Evanston09/pentos/hardware/manual/assets/blender/08-b-homing.png

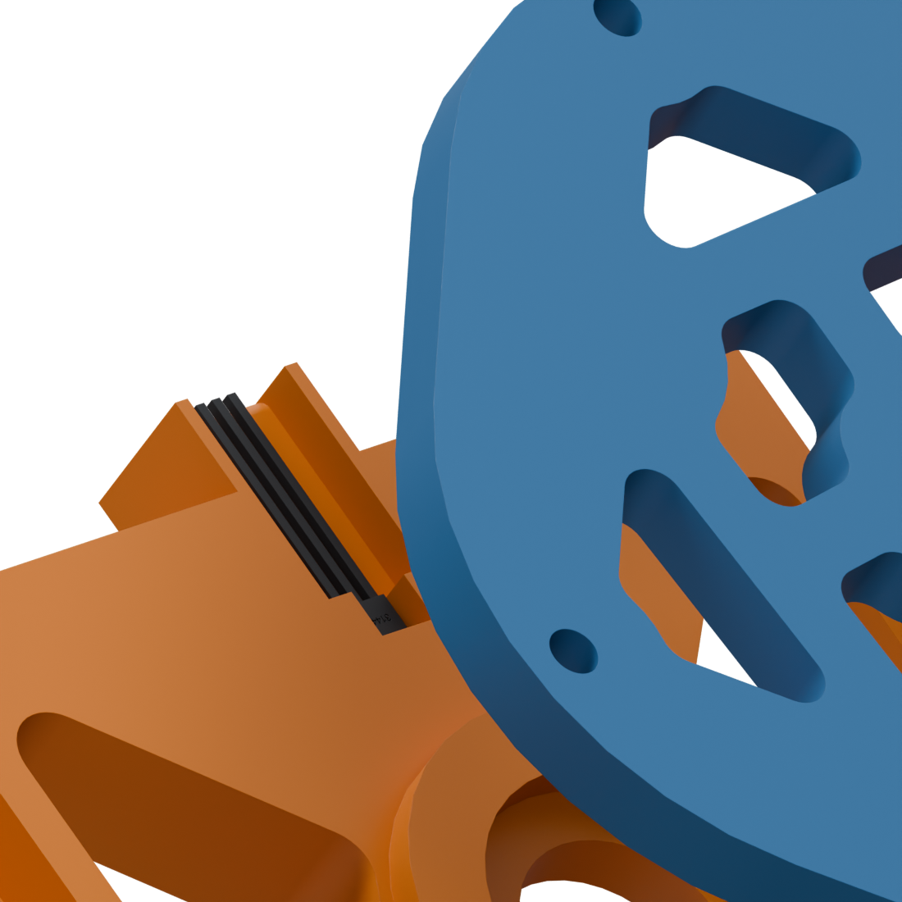
hardware/manual/assets/blender/08-b-homing.png
