Evanston09/pentos/hardware/manual/assets/blender/06-b-drive.png

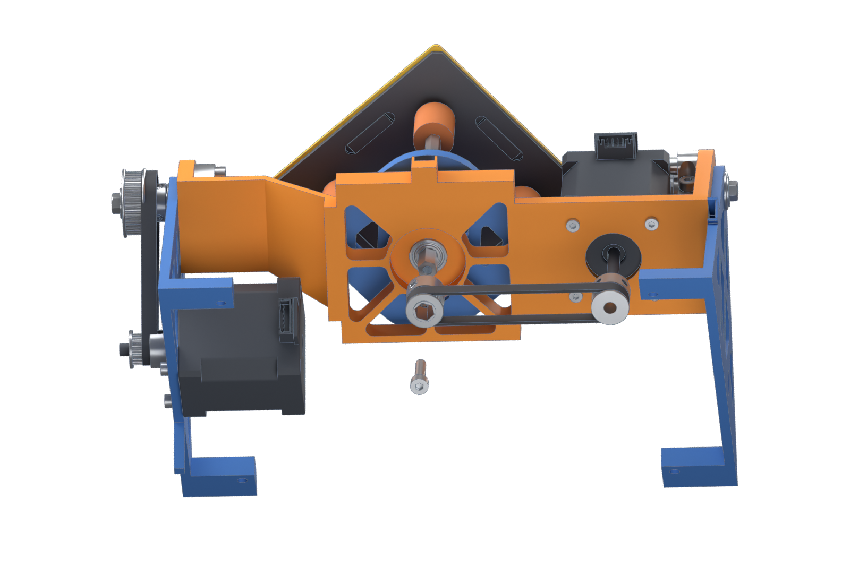
hardware/manual/assets/blender/06-b-drive.png
