Evanston09/pentos/hardware/manual/assets/blender/04b-cradle-hardware.png

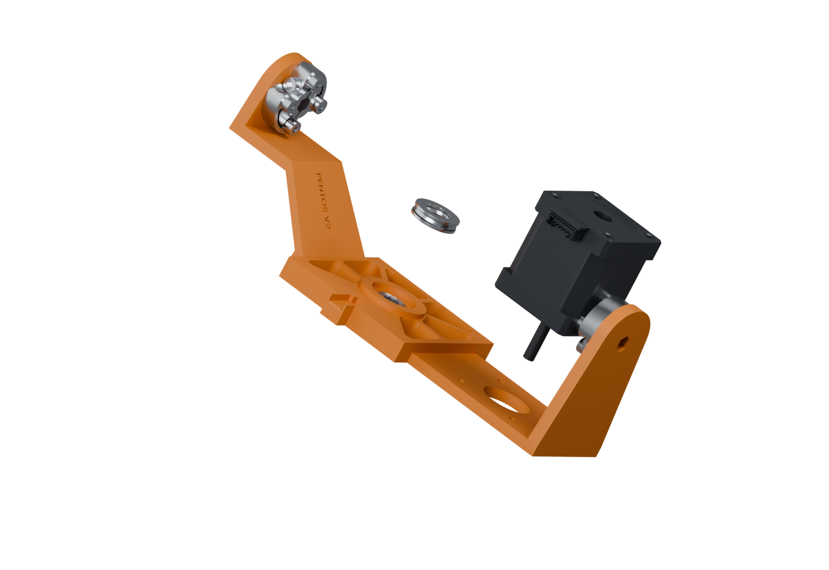
hardware/manual/assets/blender/04b-cradle-hardware.png
