Evanston09/pentos/hardware/manual/assets/blender/overview.png

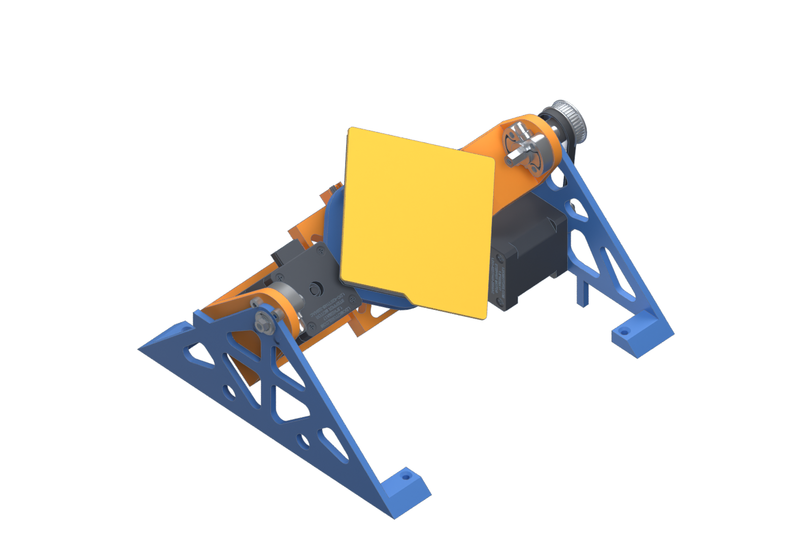
hardware/manual/assets/blender/overview.png
