Evanston09/pentos/hardware/manual/assets/pentos-paper-render.png

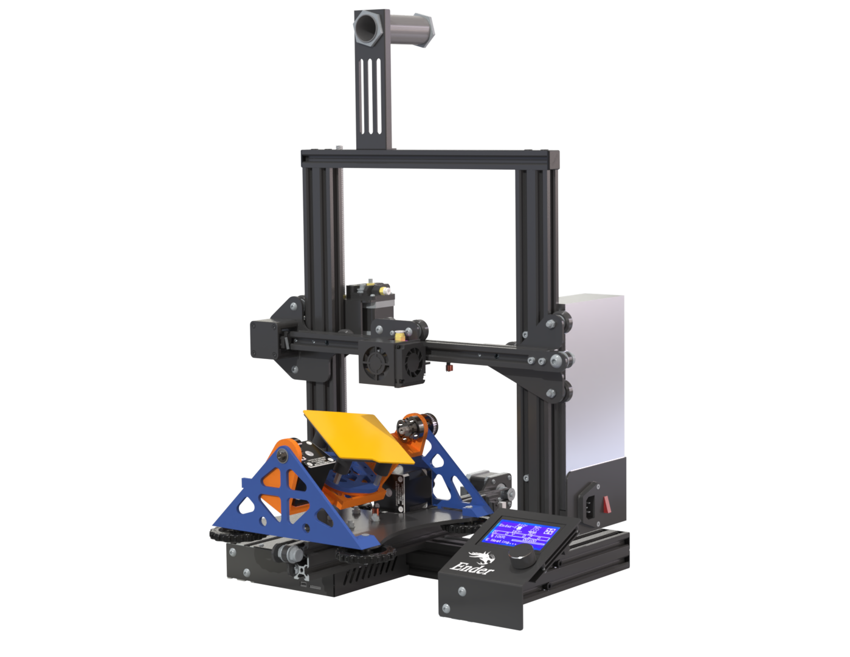
hardware/manual/assets/pentos-paper-render.png
