Evanston09/pentos/hardware/cad/a-axis-cradle.step

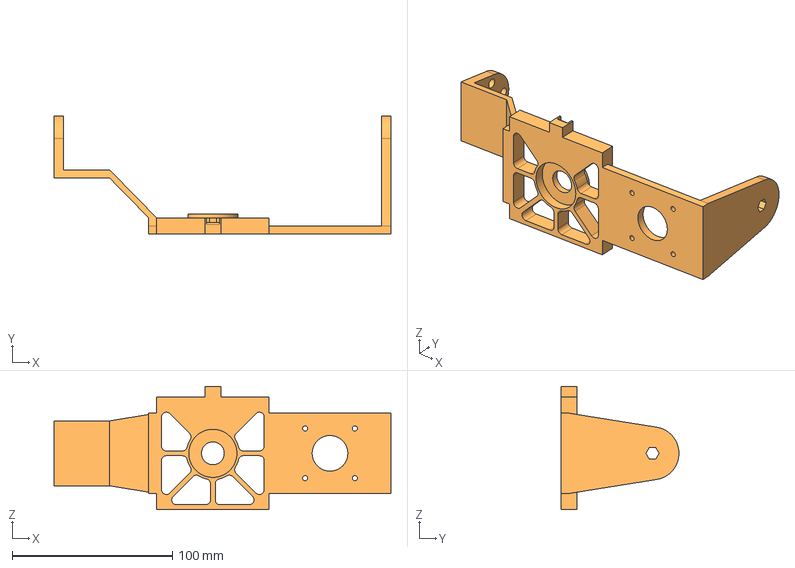
[picture p6: CAD file, 2026-11-12]
hardware/cad/a-axis-cradle.step
210.0 x 73.5 x 76.7 mm
