Evanston09/pentos/hardware/manual/Creality-Ender3-V2 - Bed Level Knob.step

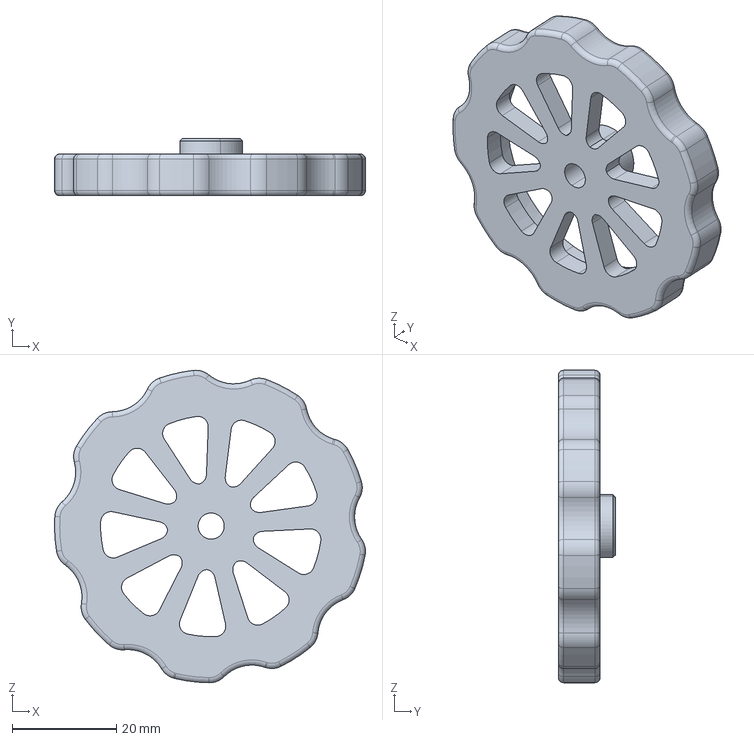
[picture p7: CAD file, 2026-11-12]
hardware/manual/Creality-Ender3-V2 - Bed Level Knob.step
59.5 x 11.0 x 59.8 mm
