Evanston09/pentos/hardware/manual/slicing/a-axis-cradle-magnet-pause.3mf

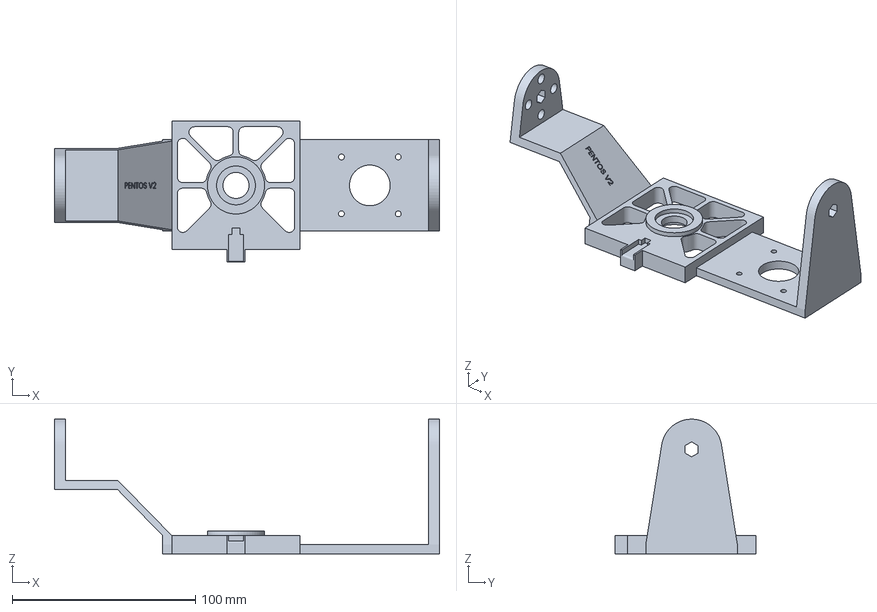
[picture p8: CAD file, 2026-11-12]
hardware/manual/slicing/a-axis-cradle-magnet-pause.3mf
210.0 x 76.7 x 73.5 mm
