Evanston09/pentos/hardware/Pentos.step

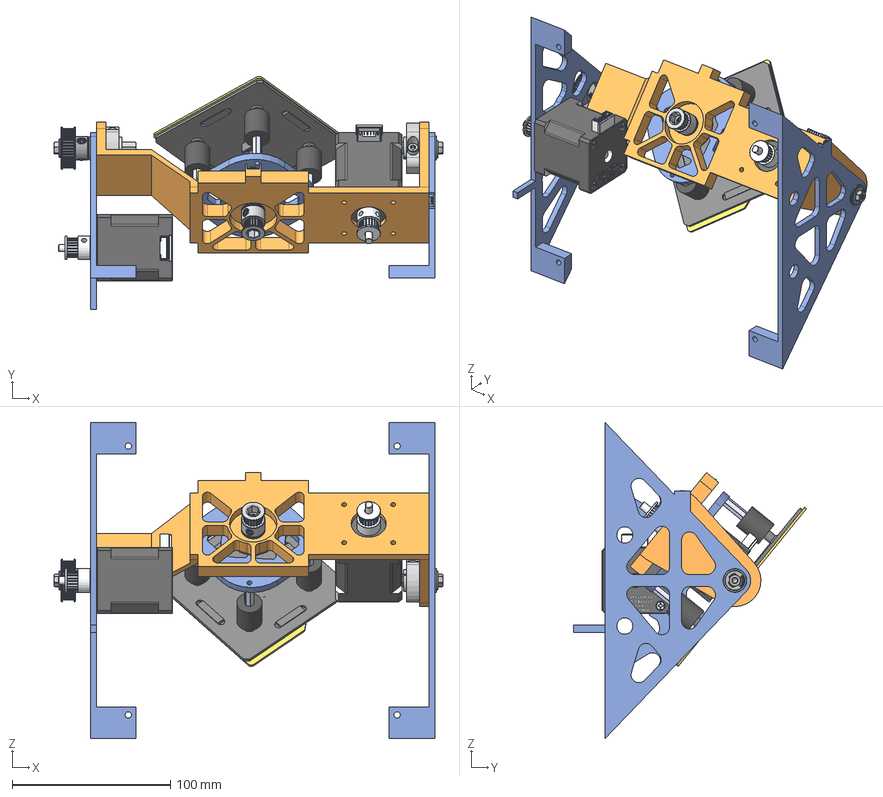
[picture p9: CAD file, 2026-11-12]
hardware/Pentos.step
246.0 x 147.5 x 200.0 mm
Gates_2GT_20T_Toothed_Pulley x 2
2106 Series 8mm REX e-clip
2106 Series Stainless Steel REX Shaft (8mm Diameter, 52mm Length)
outer race x 3
inner race x 3
1309 Series Sonic Hub (8mm REX® Bore) 1309-0016-4 008 x 2
8mm REX® Shaft with E-Clip (Stainless Steel, 32mm Length) 2106-40 08-0320 x 2
2806-0005-0004 v8
Sensor x 2
U-Axis Holder Back
2mm Pitch GT2 Pinion Timing Pulley (8mm REX Bore, 20 Tooth) 3422-400 8-0020
LDO Nema_17_47STH (höhe 48 mm) v4 x 2
U-Axis Craddle
U-Axis Holder
Washer x 2
Carriage With Balls
REV-41-1489 x 4
Buildplate
Spacer x 4
Magnet x 2
V-Axis Base
Prusa Magnetic Heatbed Tile v3
