Evanston09/pentos/hardware/printable-parts/b-axis-base.3mf

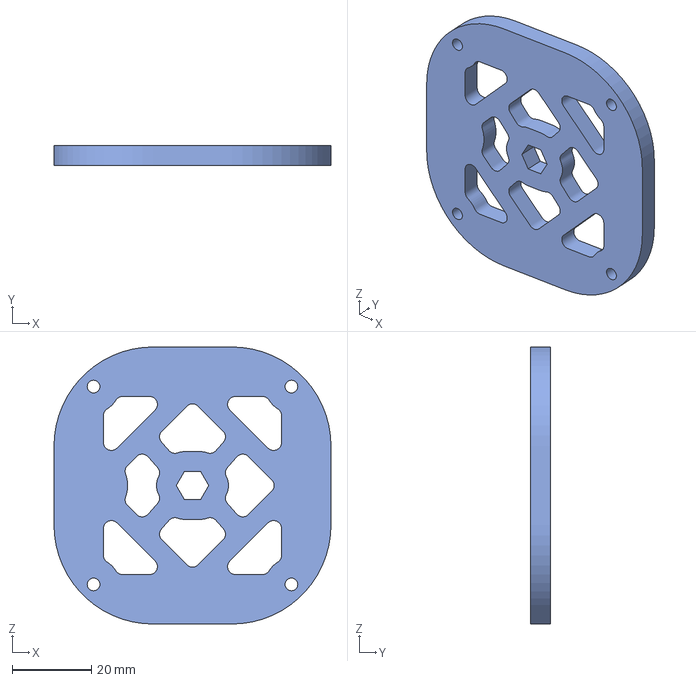
[picture p10: CAD file, 2026-11-12]
hardware/printable-parts/b-axis-base.3mf
70.0 x 5.00 x 70.0 mm
