Evanston09/pentos/hardware/cad/rex-shaft-e-clip.step

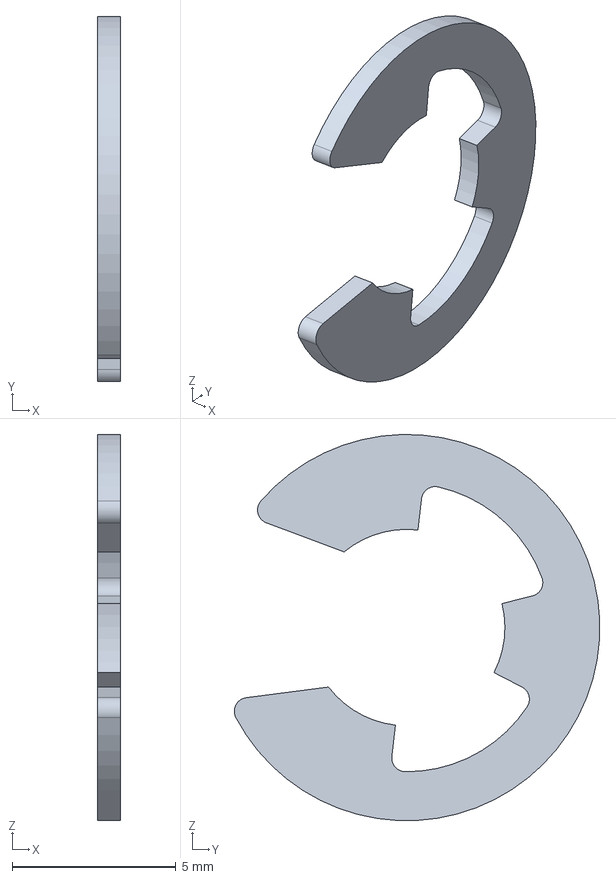
[picture p11: CAD file, 2026-11-12]
hardware/cad/rex-shaft-e-clip.step
0.7 x 11.2 x 11.8 mm
