Evanston09/pentos/hardware/manual/Creality-Ender3-V2 - Y-Gantry.step

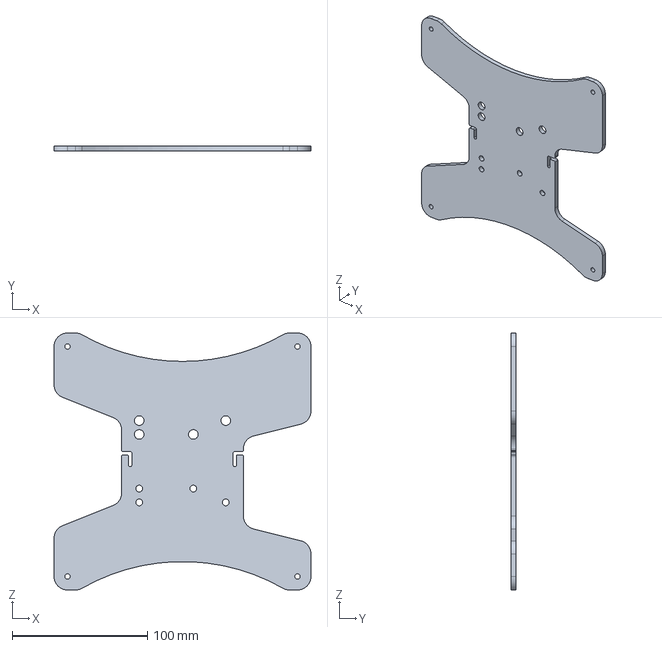
[picture p12: CAD file, 2026-11-12]
hardware/manual/Creality-Ender3-V2 - Y-Gantry.step
190.0 x 4.00 x 190.0 mm
