Evanston09/pentos/hardware/cad/a-axis-holder-back.step

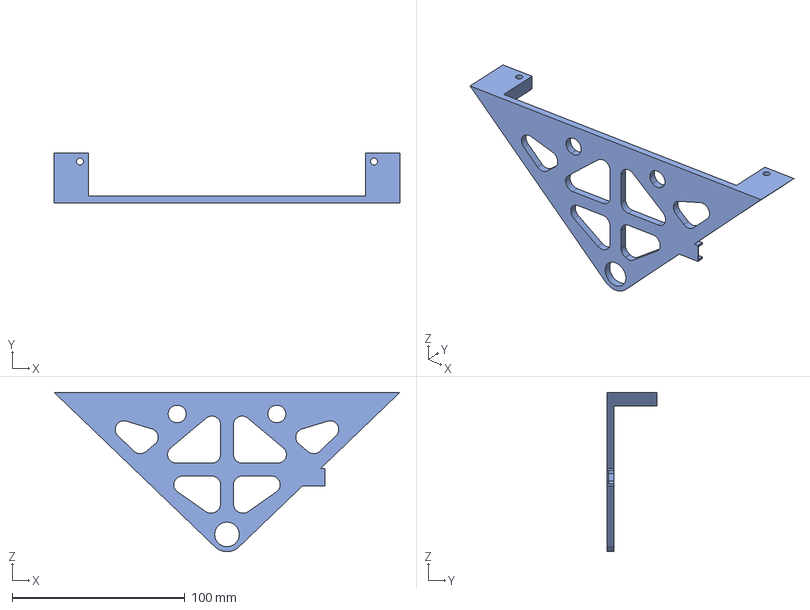
[picture p13: CAD file, 2026-11-12]
hardware/cad/a-axis-holder-back.step
200.0 x 29.0 x 92.1 mm
