Evanston09/pentos/hardware/cad/a-axis-holder-front.step

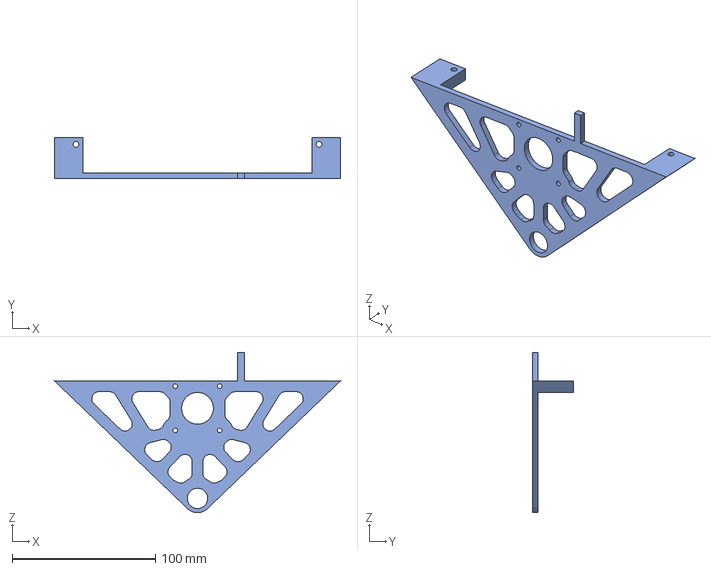
[picture p14: CAD file, 2026-11-12]
hardware/cad/a-axis-holder-front.step
200.0 x 29.0 x 112.1 mm
