Evanston09/pentos/(list of files, cad)

Other CAD files:
hardware/manual/slicing/b-axis-base-magnet-pause.3mf
hardware/manual/pentos-assembly.blend
hardware/manual/pentos-mounted.blend
hardware/printable-parts/a-axis-cradle.3mf
hardware/printable-parts/a-axis-holder-back.3mf
hardware/printable-parts/a-axis-holder-front.3mf
