Evanston09/pentos/hardware/manual/assets/a-drive-photo.jpg

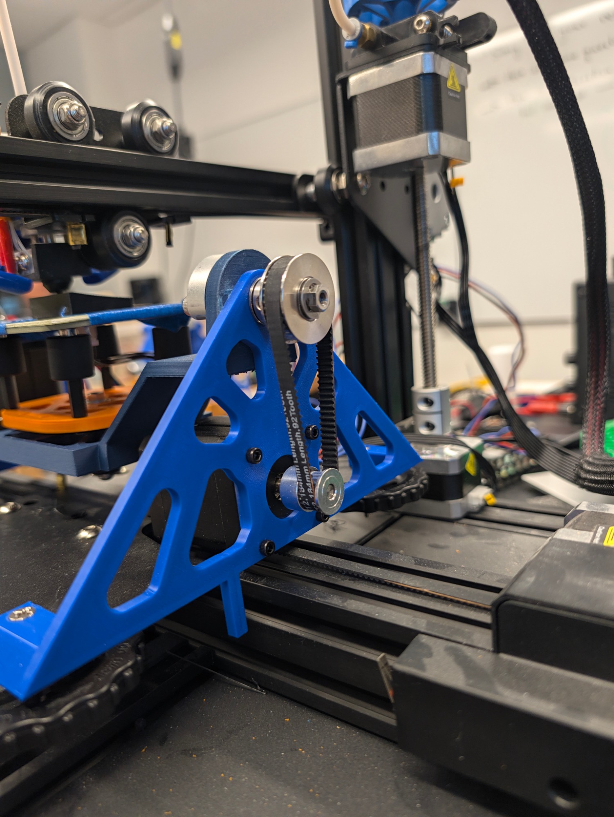
hardware/manual/assets/a-drive-photo.jpg
