Evanston09/pentos/hardware/manual/assets/a-homing-reference.png

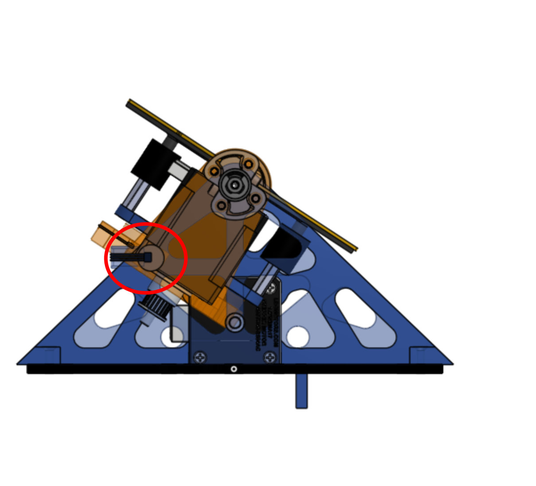
hardware/manual/assets/a-homing-reference.png
