Evanston09/pentos/hardware/manual/assets/assembly.png

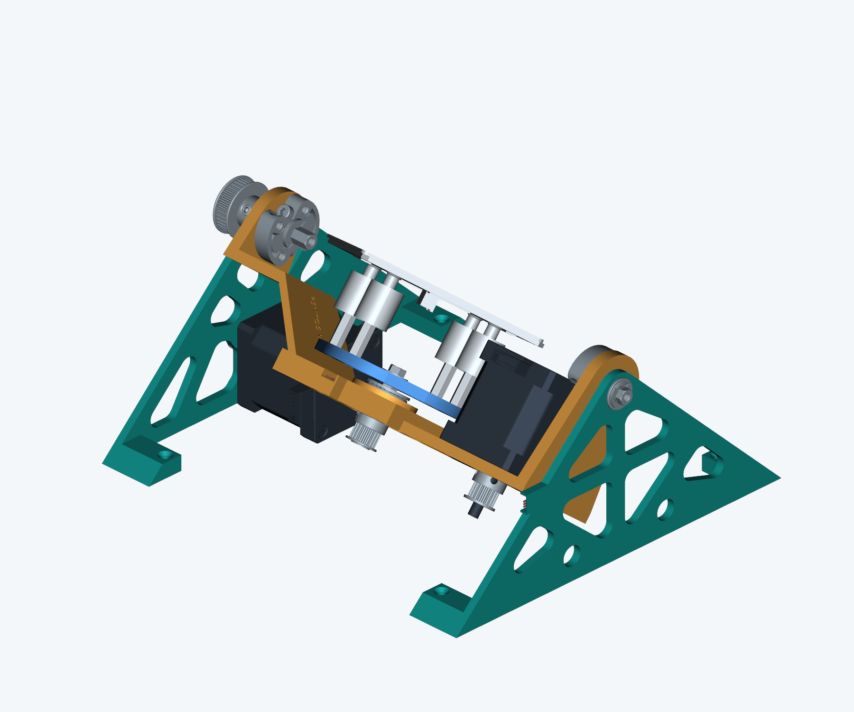
hardware/manual/assets/assembly.png
