Evanston09/pentos/hardware/manual/assets/b-drive-photo.jpg

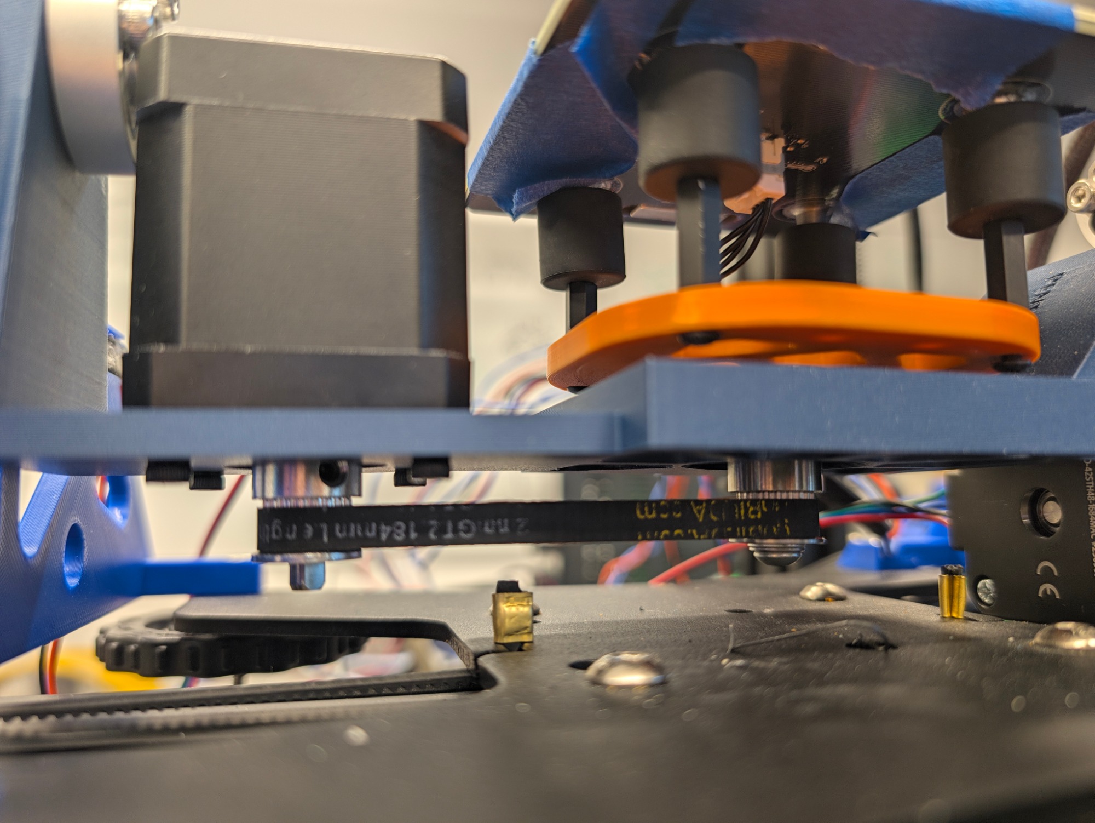
hardware/manual/assets/b-drive-photo.jpg
