Evanston09/pentos/hardware/manual/assets/b-homing-reference.png

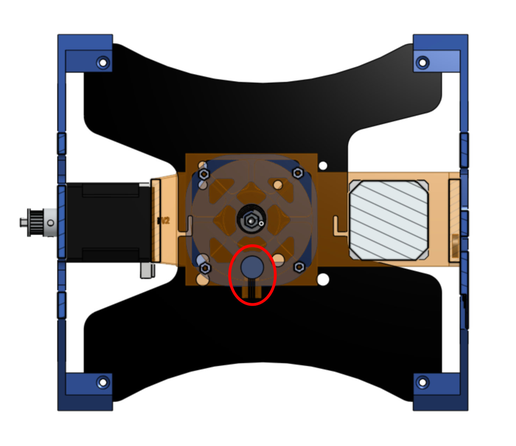
hardware/manual/assets/b-homing-reference.png
