Evanston09/pentos/hardware/manual/assets/bed.png

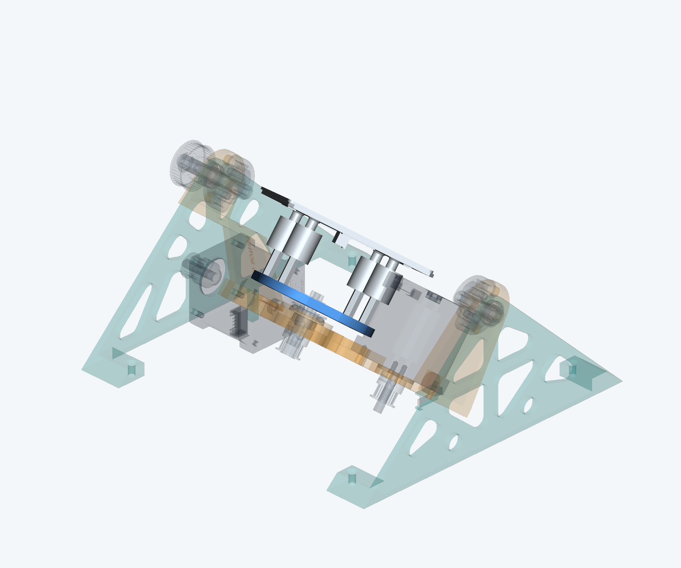
hardware/manual/assets/bed.png
