Evanston09/pentos/hardware/manual/assets/blender/01-bed.png

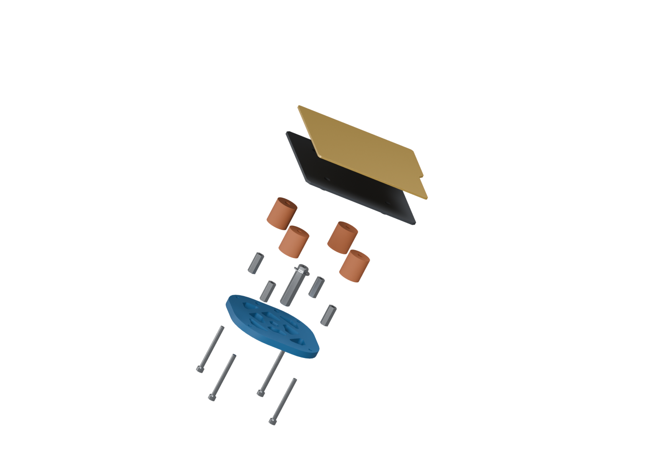
hardware/manual/assets/blender/01-bed.png
