Evanston09/pentos/hardware/manual/assets/blender/02-hubs.png

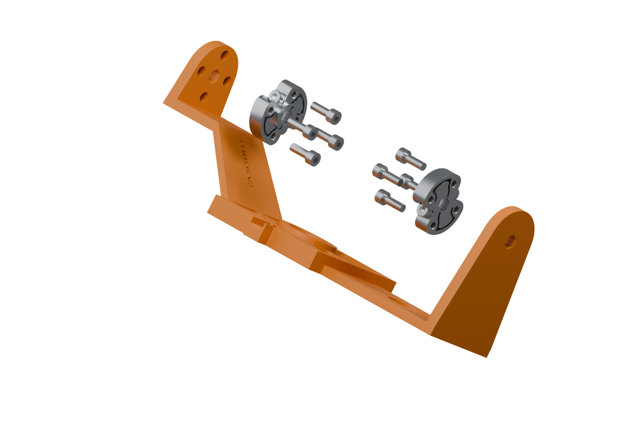
hardware/manual/assets/blender/02-hubs.png
