Evanston09/pentos/hardware/manual/assets/blender/03-holders.png

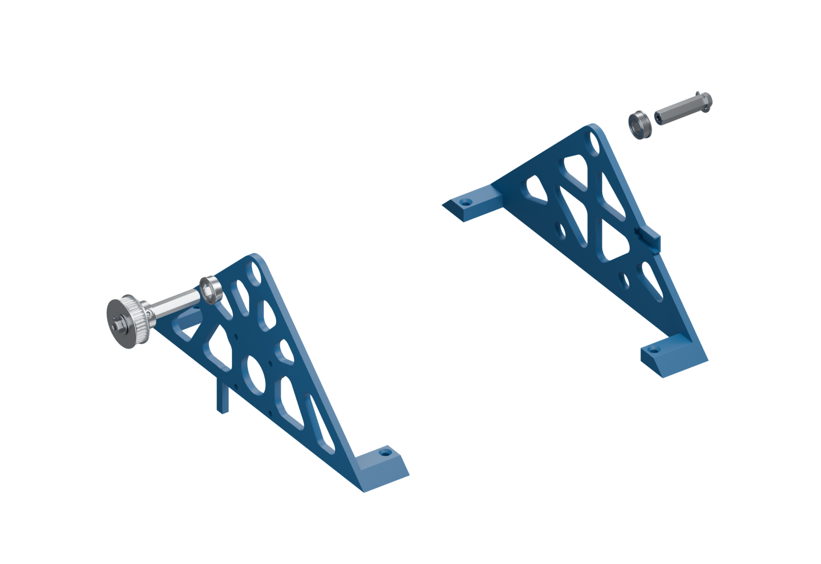
hardware/manual/assets/blender/03-holders.png
