Evanston09/pentos/hardware/manual/assets/blender/04-a-drive.png

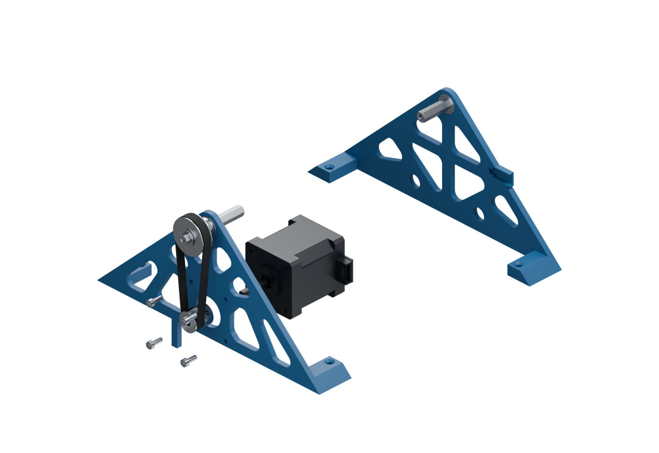
hardware/manual/assets/blender/04-a-drive.png
