Evanston09/pentos/hardware/manual/assets/blender/04a-cradle-bearing.png

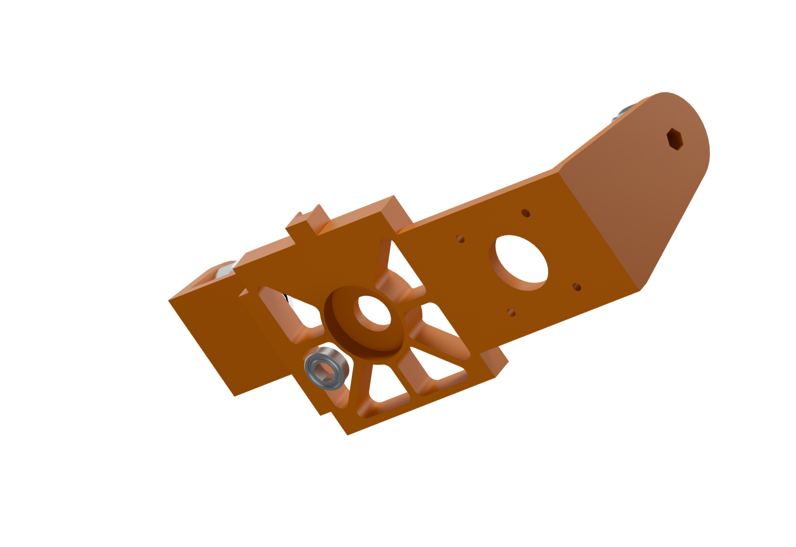
hardware/manual/assets/blender/04a-cradle-bearing.png
