Evanston09/pentos/hardware/manual/assets/blender/04c-motor-screws.png

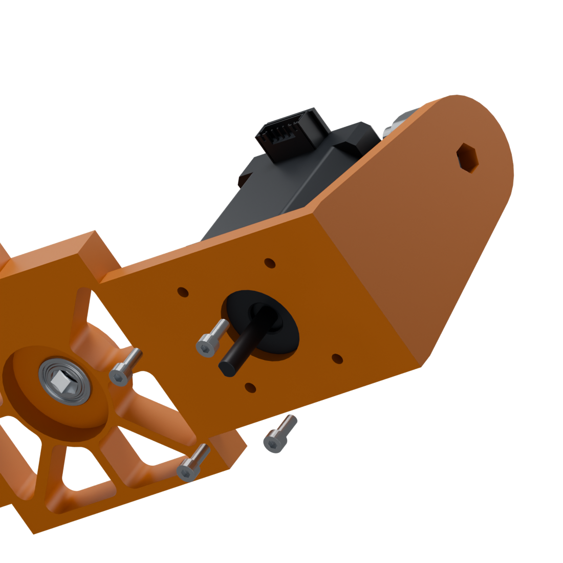
hardware/manual/assets/blender/04c-motor-screws.png
