Evanston09/pentos/hardware/manual/assets/blender/04d-fit-cradle.png

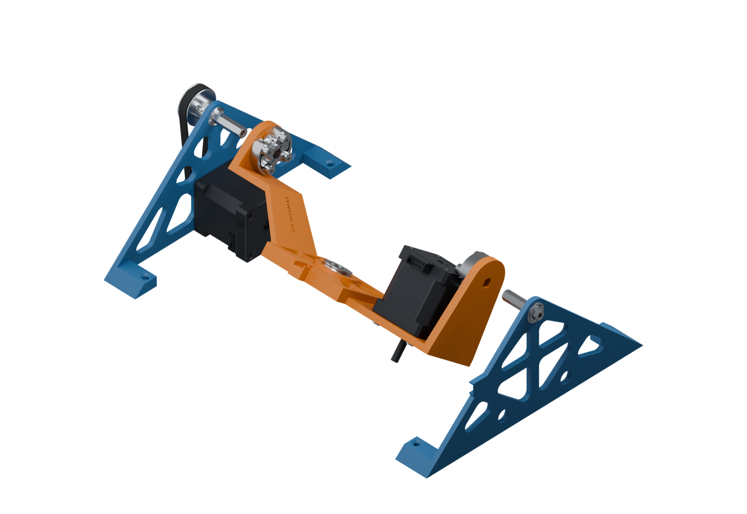
hardware/manual/assets/blender/04d-fit-cradle.png
