Evanston09/pentos/hardware/manual/assets/blender/05-bed-on-cradle.png

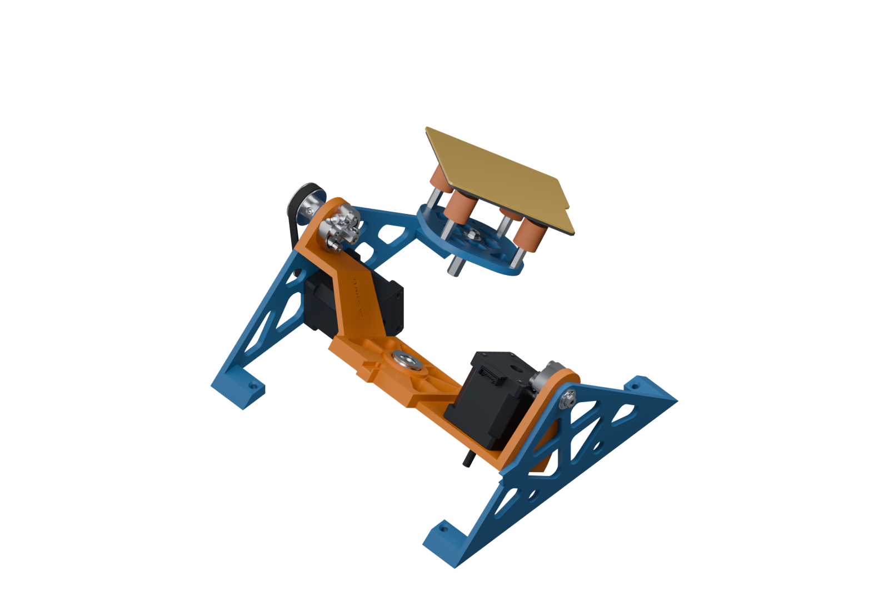
hardware/manual/assets/blender/05-bed-on-cradle.png
