Evanston09/pentos/hardware/manual/assets/blender/06c-screw-detail.png

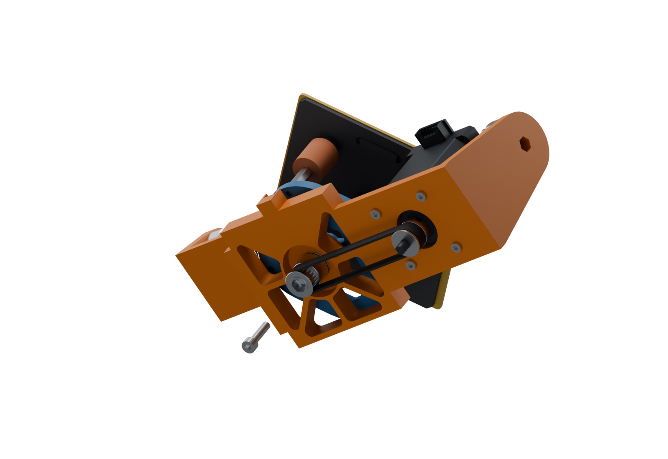
hardware/manual/assets/blender/06c-screw-detail.png
