Evanston09/pentos/hardware/manual/assets/blender/07-hub-left.png

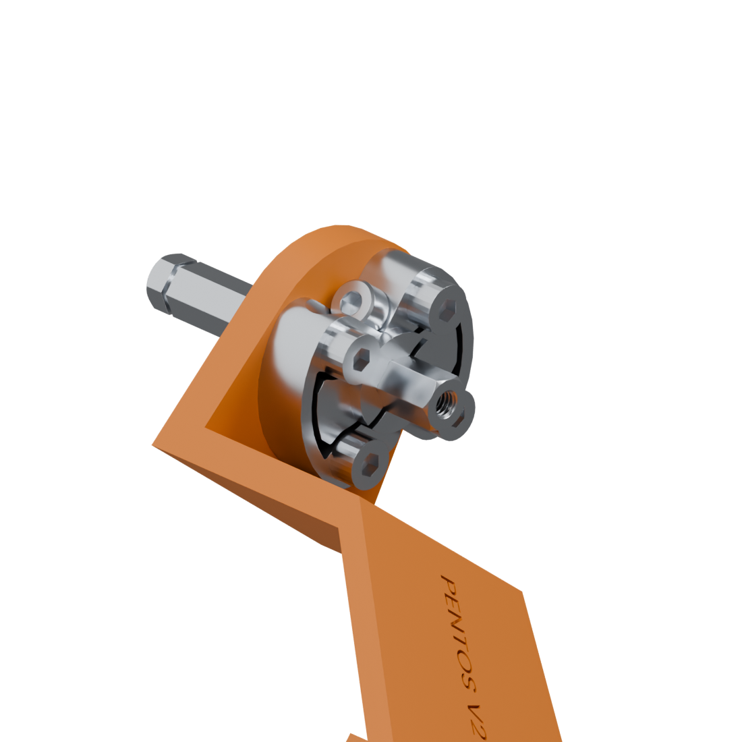
hardware/manual/assets/blender/07-hub-left.png
