Evanston09/pentos/hardware/manual/assets/blender/07-hub-right.png

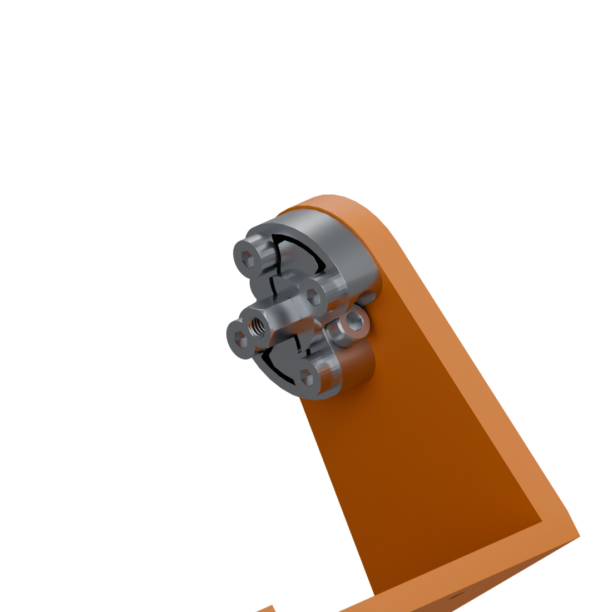
hardware/manual/assets/blender/07-hub-right.png
