Evanston09/pentos/hardware/manual/assets/blender/07-tighten.png

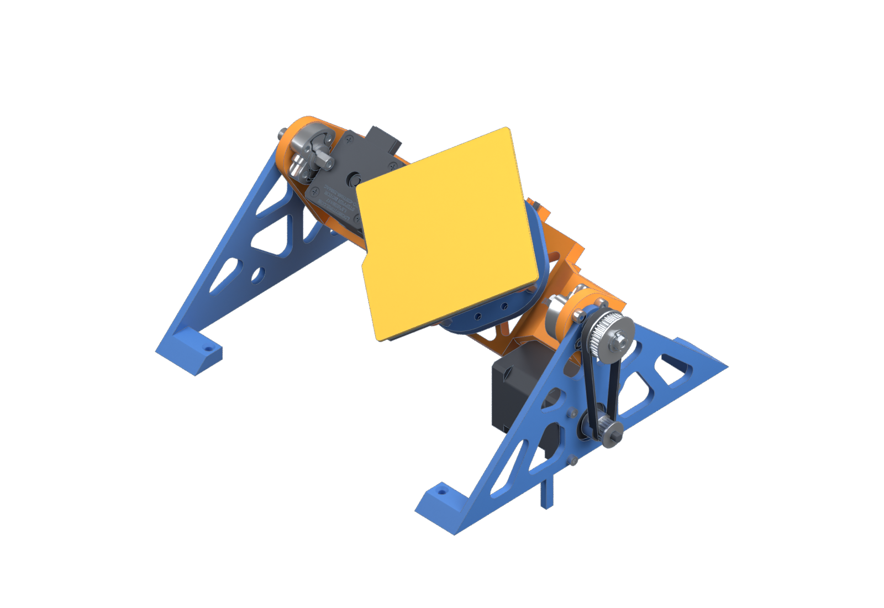
hardware/manual/assets/blender/07-tighten.png
