Evanston09/pentos/hardware/manual/assets/blender/08-a-homing.png

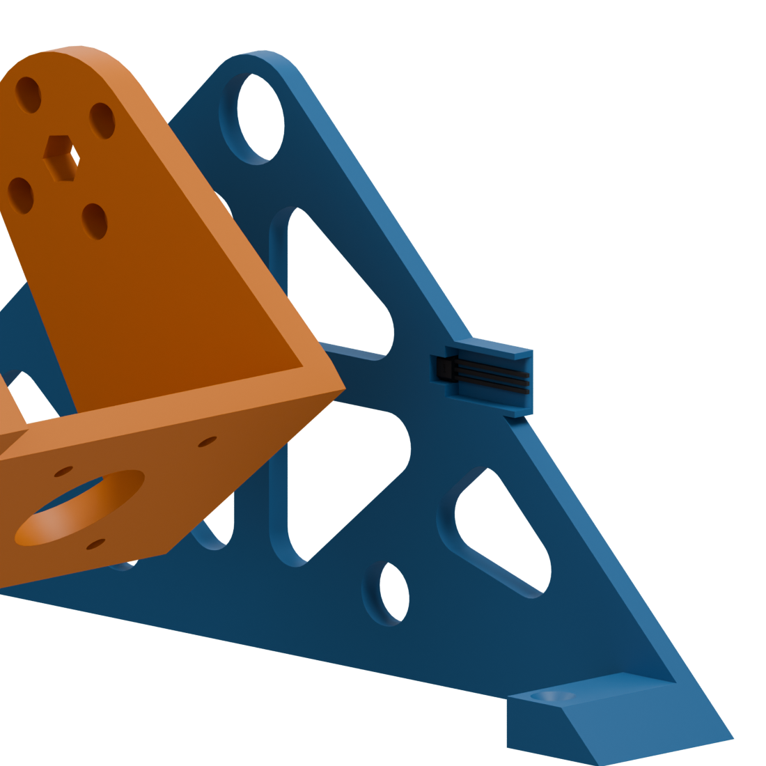
hardware/manual/assets/blender/08-a-homing.png
