Evanston09/pentos/hardware/manual/assets/blender/09-mount-detail.png

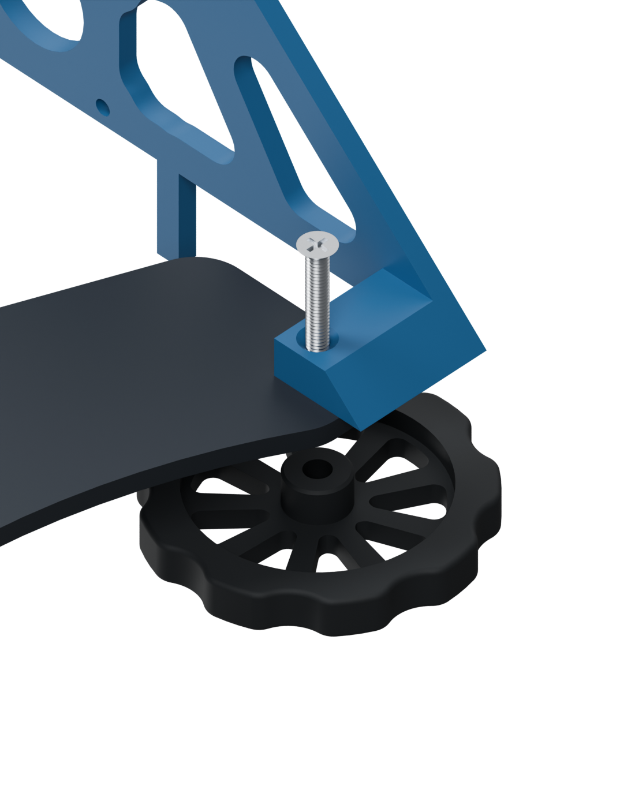
hardware/manual/assets/blender/09-mount-detail.png
