Evanston09/pentos/hardware/manual/assets/blender/09-mounted.png

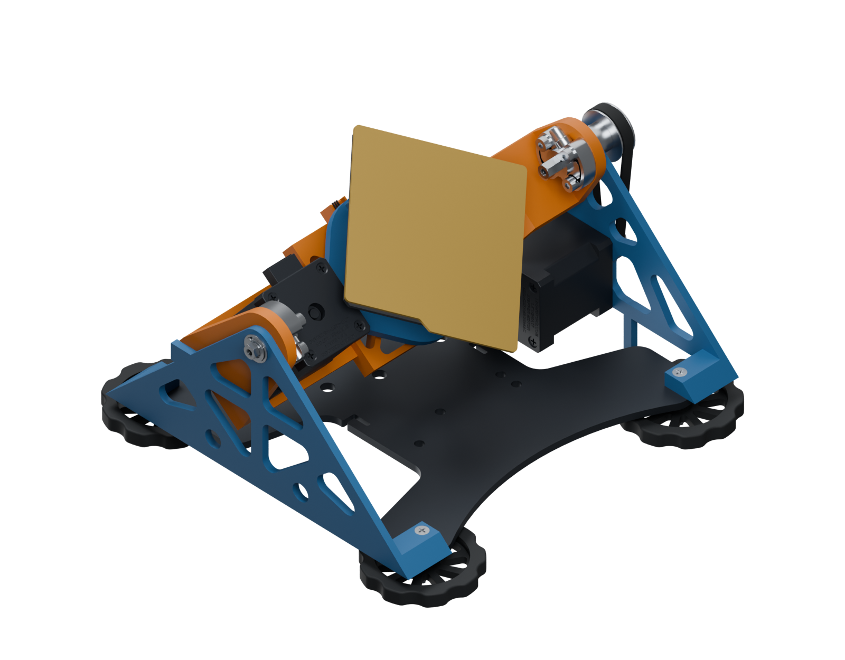
hardware/manual/assets/blender/09-mounted.png
