Evanston09/pentos/hardware/manual/assets/exploded.png

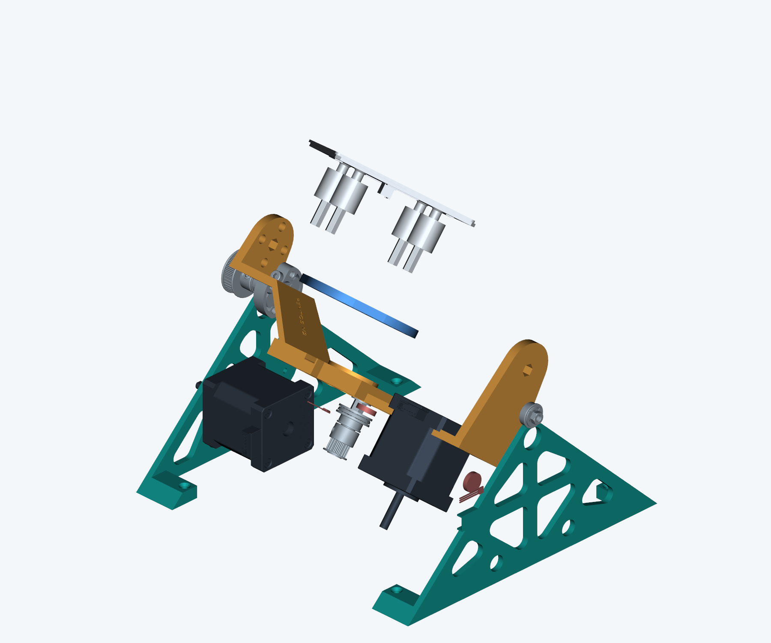
hardware/manual/assets/exploded.png
