Evanston09/pentos/hardware/manual/assets/homing.png

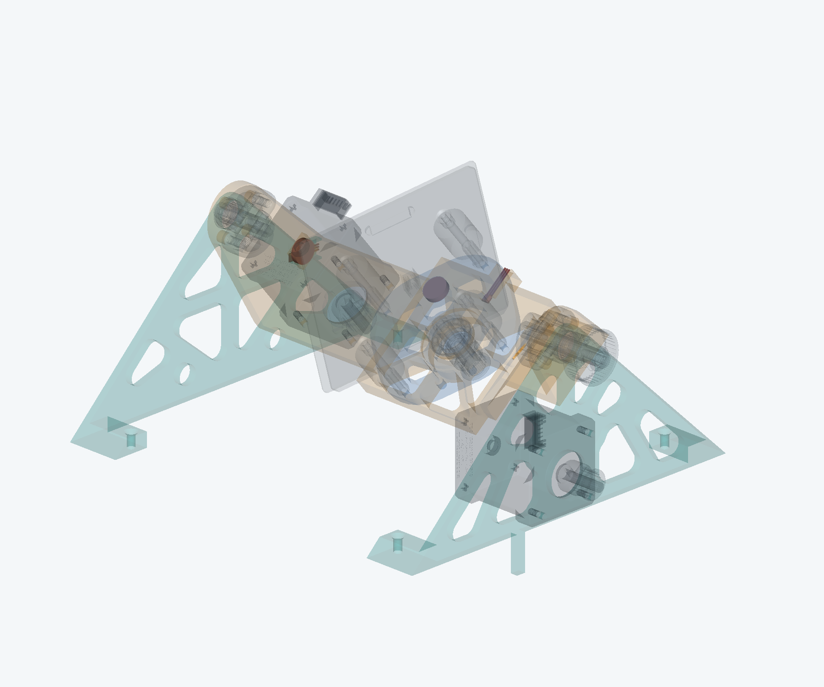
hardware/manual/assets/homing.png
