Evanston09/pentos/hardware/manual/assets/magnet-preparation/a-axis-cradle-detail.png

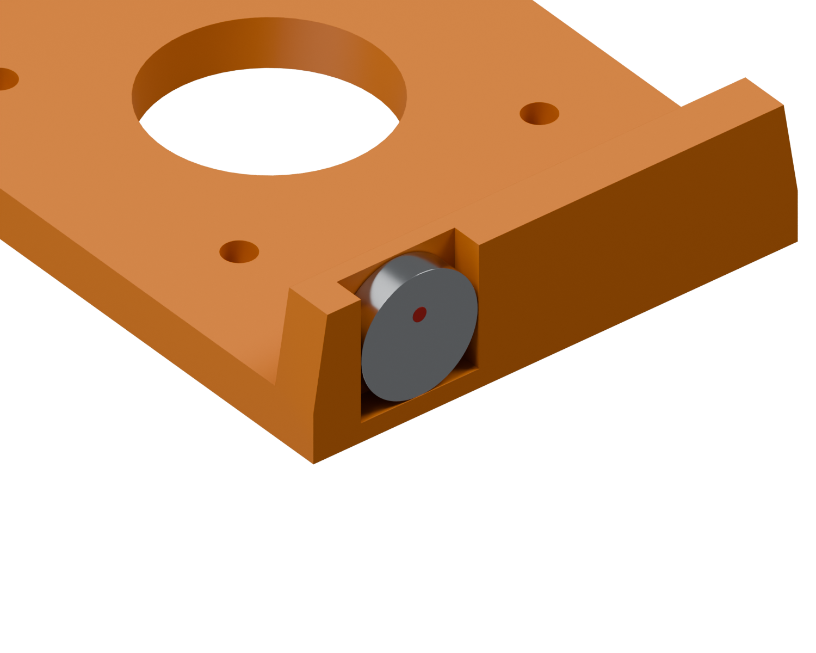
hardware/manual/assets/magnet-preparation/a-axis-cradle-detail.png
