Evanston09/pentos/hardware/manual/assets/magnet-preparation/b-axis-base-detail.png

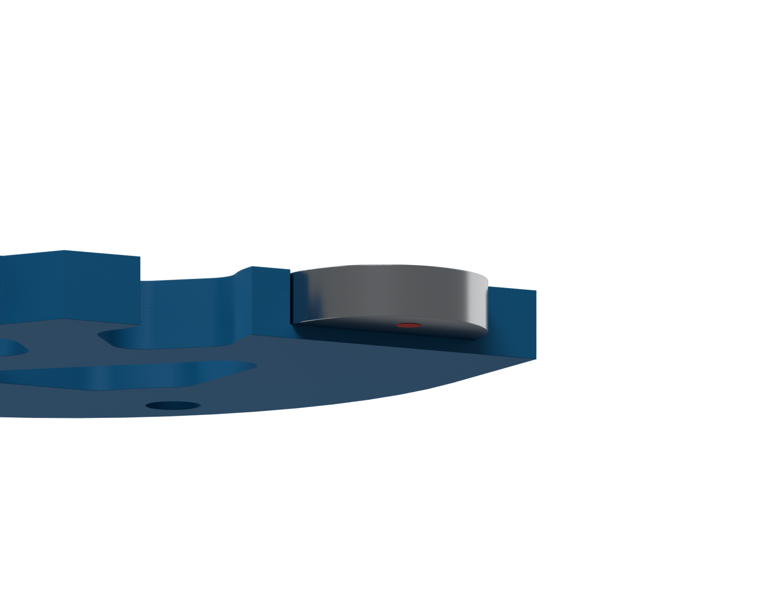
hardware/manual/assets/magnet-preparation/b-axis-base-detail.png
