Evanston09/pentos/hardware/manual/assets/rotation.png

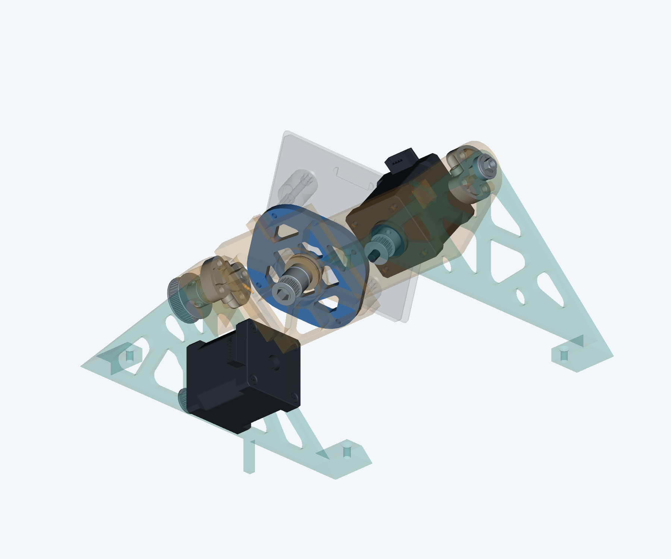
hardware/manual/assets/rotation.png
