Evanston09/pentos/TODO.md

Figure out concept of a home
Remove unnecessary pacakages
