Evanston09/pentos/hardware/manual/slicing/a-axis-cradle-reference.ini

# Layer-reference setup. Select your actual printer/filament before export.
layer_height = 0.2
first_layer_height = 0.2
nozzle_diameter = 0.4
filament_diameter = 1.75
extrusion_width = 0.45
perimeters = 3
fill_density = 15%
fill_pattern = rectilinear
top_solid_layers = 4
bottom_solid_layers = 4
raft_layers = 0
skirts = 0
brim_width = 0
gcode_comments = 1
use_relative_e_distances = 0
bed_shape = 0x0,220x0,220x220,0x220
max_print_height = 250
support_material = 1
support_material_buildplate_only = 1
support_material_style = snug
support_material_contact_distance = 0.2
