Evanston09/pentos/(commit log)

2026-04-20 Basic Klipper setup
    [printer.cfg]
2026-04-21 Spawn things
    [pentos.urdf]
2026-04-21 Add package
    [pentos.urdf, pentos_controllers.yaml]
2026-04-29 feat: add klipper bridge integration
2026-04-29 Made Klipper and Moonraker
    [sim-printer.cfg]
2026-06-12 Major restructure
    [pentos.urdf, pentos_controllers.yaml, printer.cfg, sim-printer.cfg]
2026-06-16 Basic cutting and slicing implemented
    [t_shape.3mf, t_shape.stl]
2026-06-17 Add build plate to viewport and represent in mm
2026-06-23 Heated bed working now!
2026-06-23 Add slicer as submodule
    [t_shape.3mf, t_shape.stl]
2026-07-06 Add RPhys printer configuration
    [ender3v2.cfg]
